michaelshiloh/didi/(commit log)

2021-07-07 added readme and connector diagram
2021-09-12 renamed to make Arduino happy
2021-09-21 4 motors for big model
2021-09-29 added assembly instructions
